bemelab/nrf24L01-modules/README.md

# nRF24L01+ modülleri — Elfatek

nRF24L01+ tabanlı RF modül tasarımları. Her proje kendi klasöründe, kendi README'si ve tasarım notlarıyla durur.

| Proje | Klasör | İçerik |
|---|---|---|
| **nRF24L01+ PA/LNA modülleri** | [`nrf24-pa-module/`](nrf24-pa-module) | 19 mm genişlikte, standart 2×4 pin dizilimli kartlar: NRF24PA, NRF24PL (RFX2401C PA/LNA), NRF24DN (PA'sız), NRF24DP (PA'lı, regülatörlü) |

Tasarımlar KiCad 9 ile, tablolardan Python betikleriyle üretilir. **Kartlar henüz test edilmedi.**
