bemelab/nrf24L01-modules/nrf24-pa-module/NRF24DP/docs/kart_alt.png

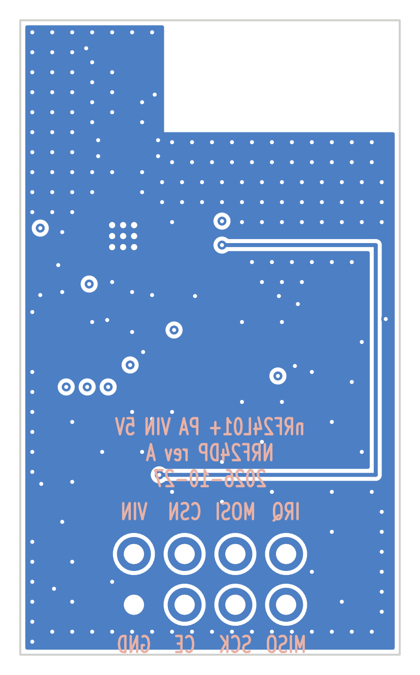
nrf24-pa-module/NRF24DP/docs/kart_alt.png
