bemelab/nrf24L01-modules/nrf24-pa-module/uretim/NRF24PA_BOM.csv

Referans | Deger | Footprint | MPN | Adet | DNP
AE1 | 2450AT18A100E | RF_Antenna:Johanson_2450AT18x100 | Johanson 2450AT18A100E | 1
C1,C2 | 22pF | Capacitor_SMD:C_0402_1005Metric | NP0 50V | 2
C3 | 2.2nF | Capacitor_SMD:C_0402_1005Metric | X7R | 1
C4 | 4.7pF | Capacitor_SMD:C_0402_1005Metric | NP0 +/-0.25pF | 1
C5,C16,C17,C18,C19 | 1.5pF | Capacitor_SMD:C_0402_1005Metric | NP0 +/-0.1pF | 5
C6 | 1.0pF | Capacitor_SMD:C_0402_1005Metric | NP0 +/-0.1pF | 1
C7 | 33nF | Capacitor_SMD:C_0402_1005Metric | X7R | 1
C8 | 1nF | Capacitor_SMD:C_0402_1005Metric | X7R | 1
C9 | 10nF | Capacitor_SMD:C_0402_1005Metric | X7R | 1
C10 | 10uF | Capacitor_SMD:C_0805_2012Metric | X5R 10V | 1
C11 | 100nF | Capacitor_SMD:C_0402_1005Metric | X7R | 1
C12 | 1uF | Capacitor_SMD:C_0402_1005Metric | X5R 10V | 1
C13 | 220pF | Capacitor_SMD:C_0402_1005Metric | NP0 | 1
C14 | 10uF | Capacitor_SMD:C_0603_1608Metric | X5R 10V | 1
C15 | 0.3pF | Capacitor_SMD:C_0402_1005Metric | NP0 +/-0.05pF | 1
C20,C21 | DNP | Capacitor_SMD:C_0402_1005Metric |  | 2 | Yerleştirilmemeli
J1 | nRF24 2x4 | Connector_PinHeader_2.54mm:PinHeader_2x04_P2.54mm_Vertical |  | 1
J2 | U.FL | Connector_Coaxial:U.FL_Hirose_U.FL-R-SMT-1_Vertical | Hirose U.FL-R-SMT-1(10) | 1
L1 | 8.2nH | Inductor_SMD:L_0402_1005Metric | LQG15HS8N2J02 (Murata) | 1
L2 | 2.7nH | Inductor_SMD:L_0402_1005Metric | LQG15HS2N7S02 | 1
L3 | 3.9nH | Inductor_SMD:L_0402_1005Metric | LQG15HS3N9S02 | 1
L4,L5 | 2.4nH | Inductor_SMD:L_0402_1005Metric | LQG15HS2N4S02 | 2
L6 | 0R | Inductor_SMD:L_0402_1005Metric |  | 1
R1 | 22k 1% | Resistor_SMD:R_0402_1005Metric |  | 1
R2,R3 | 10k | Resistor_SMD:R_0402_1005Metric |  | 2
R4 | 10k | Resistor_SMD:R_0402_1005Metric |  | 1 | Yerleştirilmemeli
R5 | 0R | Resistor_SMD:R_0402_1005Metric |  | 1 | Yerleştirilmemeli
R6 | 0R | Resistor_SMD:R_0402_1005Metric |  | 1
U1 | nRF24L01P | Package_DFN_QFN:QFN-20-1EP_4x4mm_P0.5mm_EP2.5x2.5mm | nRF24L01P-R | 1
U2 | RFX2401C | Package_DFN_QFN:QFN-16-1EP_3x3mm_P0.5mm_EP1.7x1.7mm_ThermalVias | RFX2401C (Skyworks) / AT2401C | 1
X1 | 16MHz CL=12pF | Crystal:Crystal_SMD_3225-4Pin_3.2x2.5mm | X322516MLB4SI (Yangxing) / esdegeri, +/-20ppm | 1
