bemelab/nrf24L01-modules/nrf24-pa-module/NRF24DN/uretim/NRF24DN_BOM.csv

Referans | Deger | Footprint | MPN | Adet | DNP
AE1 | 2450AT18A100E | RF_Antenna:Johanson_2450AT18x100 | Johanson 2450AT18A100E | 1
B1 | 2450BM14A0002 | elf_rf:Johanson_2450BM14_1.6x0.8mm | Johanson 2450BM14A0002001T | 1
C1,C2 | 22pF | Capacitor_SMD:C_0402_1005Metric | NP0 50V | 2
C3 | 2.2nF | Capacitor_SMD:C_0402_1005Metric | X7R | 1
C4,C5 | DNP | Capacitor_SMD:C_0402_1005Metric |  | 2 | Yerleştirilmemeli
C6 | 10uF | Capacitor_SMD:C_0805_2012Metric | X5R 25V | 1
C7 | 33nF | Capacitor_SMD:C_0402_1005Metric | X7R | 1
C8 | 1nF | Capacitor_SMD:C_0402_1005Metric | X7R | 1
C9 | 10nF | Capacitor_SMD:C_0402_1005Metric | X7R | 1
C10 | 22uF | Capacitor_Tantalum_SMD:CP_EIA-3216-18_Kemet-A | Tantal 22uF 10V A kilif | 1
J1 | nRF24 2x4 | Connector_PinHeader_2.54mm:PinHeader_2x04_P2.54mm_Vertical |  | 1
L1 | 0R | Inductor_SMD:L_0402_1005Metric |  | 1
R1 | 22k 1% | Resistor_SMD:R_0402_1005Metric |  | 1
U1 | nRF24L01P | Package_DFN_QFN:QFN-20-1EP_4x4mm_P0.5mm_EP2.5x2.5mm | nRF24L01P-R | 1
U2 | AMS1117-3.3 | Package_TO_SOT_SMD:SOT-223-3_TabPin2 | AMS1117-3.3 (AMS) / esdegeri | 1
X1 | 16MHz CL=12pF | Crystal:Crystal_SMD_3225-4Pin_3.2x2.5mm | X322516MLB4SI (Yangxing) / esdegeri, +/-20ppm | 1
