bemelab/nrf24L01-modules/nrf24-pa-module/NRF24DN/uretim/NRF24DN.step

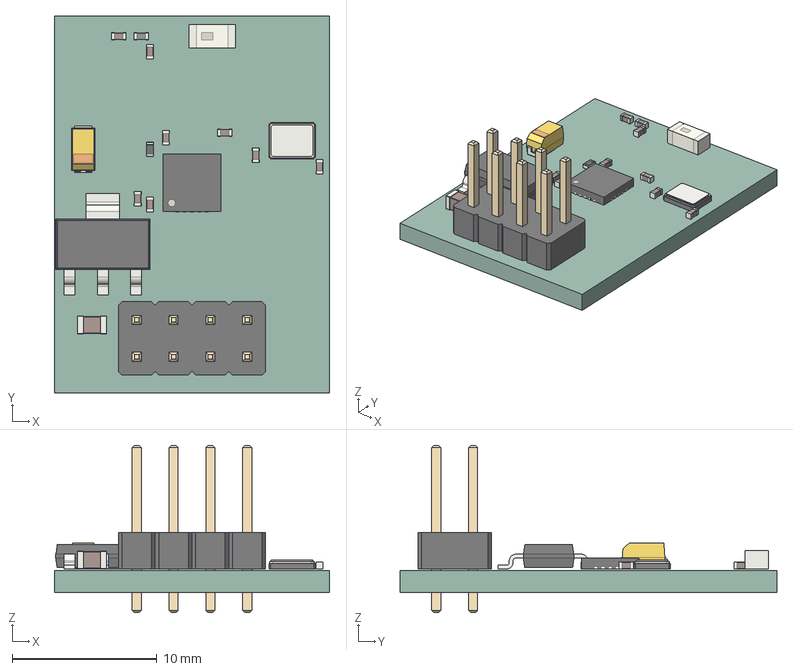
[picture p7: CAD file, 2026-10-27]
nrf24-pa-module/NRF24DN/uretim/NRF24DN.step
19.0 x 26.0 x 11.5 mm
C_0402_1005Metric x 8
CP_EIA-3216-18_Kemet-A
Crystal_SMD_3225-4Pin_3.2x2.5mm
PinHeader_2x04_P2.54mm_Vertical
R_0402_1005Metric
QFN-20-1EP_4x4mm_P0.5mm_EP2.5x2.5mm
L_0402_1005Metric
Johanson_2450AT18x100
C_0805_2012Metric
SOT-223
NRF24DN_PCB
