bemelab/nrf24L01-modules/nrf24-pa-module/NRF24DP/uretim/NRF24DP.step

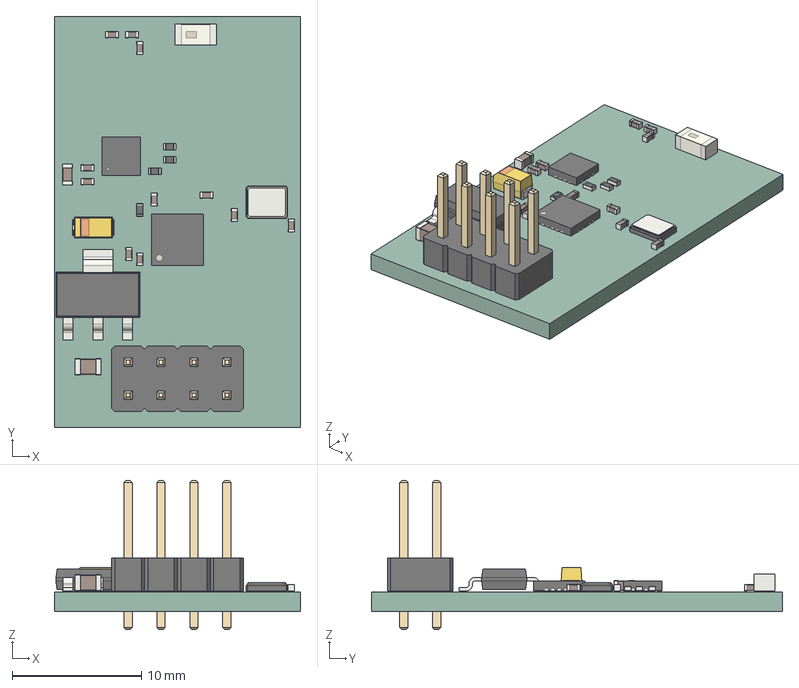
[picture p8: CAD file, 2026-10-27]
nrf24-pa-module/NRF24DP/uretim/NRF24DP.step
19.0 x 31.8 x 11.5 mm
C_0402_1005Metric x 10
QFN-20-1EP_4x4mm_P0.5mm_EP2.5x2.5mm
Crystal_SMD_3225-4Pin_3.2x2.5mm
C_0805_2012Metric
R_0402_1005Metric x 4
Johanson_2450AT18x100
SOT-223
CP_EIA-3216-18_Kemet-A
PinHeader_2x04_P2.54mm_Vertical
QFN-16-1EP_3x3mm_P0.5mm_EP1.7x1.7mm
L_0402_1005Metric
C_0603_1608Metric
NRF24DP_PCB
