bemelab/nrf24L01-modules/nrf24-pa-module/NRF24PL/uretim/NRF24PL.step

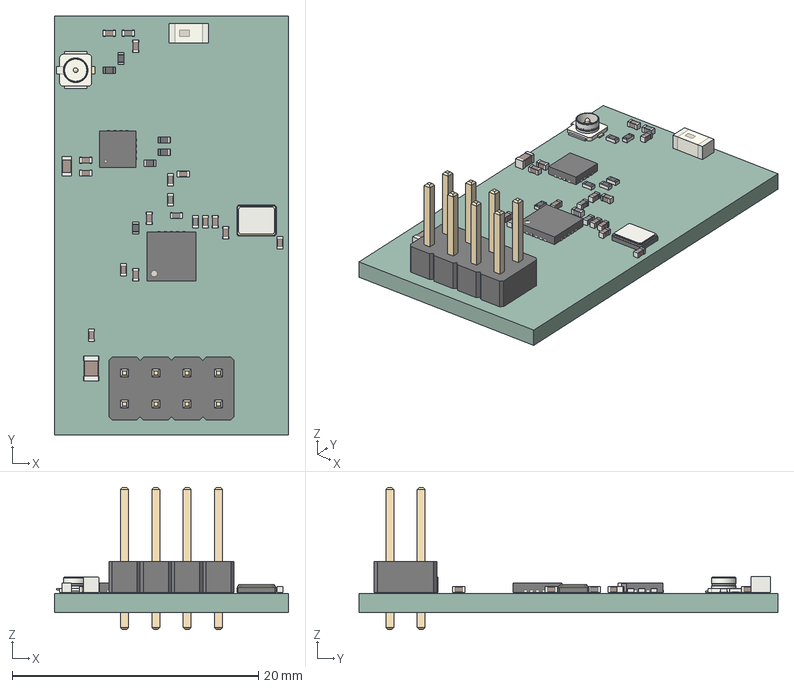
[picture p9: CAD file, 2026-10-27]
nrf24-pa-module/NRF24PL/uretim/NRF24PL.step
19.0 x 34.0 x 11.5 mm
C_0402_1005Metric x 14
R_0402_1005Metric x 6
QFN-20-1EP_4x4mm_P0.5mm_EP2.5x2.5mm
PinHeader_2x04_P2.54mm_Vertical
L_0402_1005Metric x 4
QFN-16-1EP_3x3mm_P0.5mm_EP1.7x1.7mm
C_0805_2012Metric
U.FL_Hirose_U.FL-R-SMT-1_Vertical
C_0603_1608Metric
Crystal_SMD_3225-4Pin_3.2x2.5mm
Johanson_2450AT18x100
NRF24PL_PCB
