bemelab/nrf24L01-modules/(list of files, cad)

Other CAD files:
nrf24-pa-module/uretim/NRF24PA.step
