bemelab/nrf24L01-modules/nrf24-pa-module/uretim/NRF24PA_sema.pdf

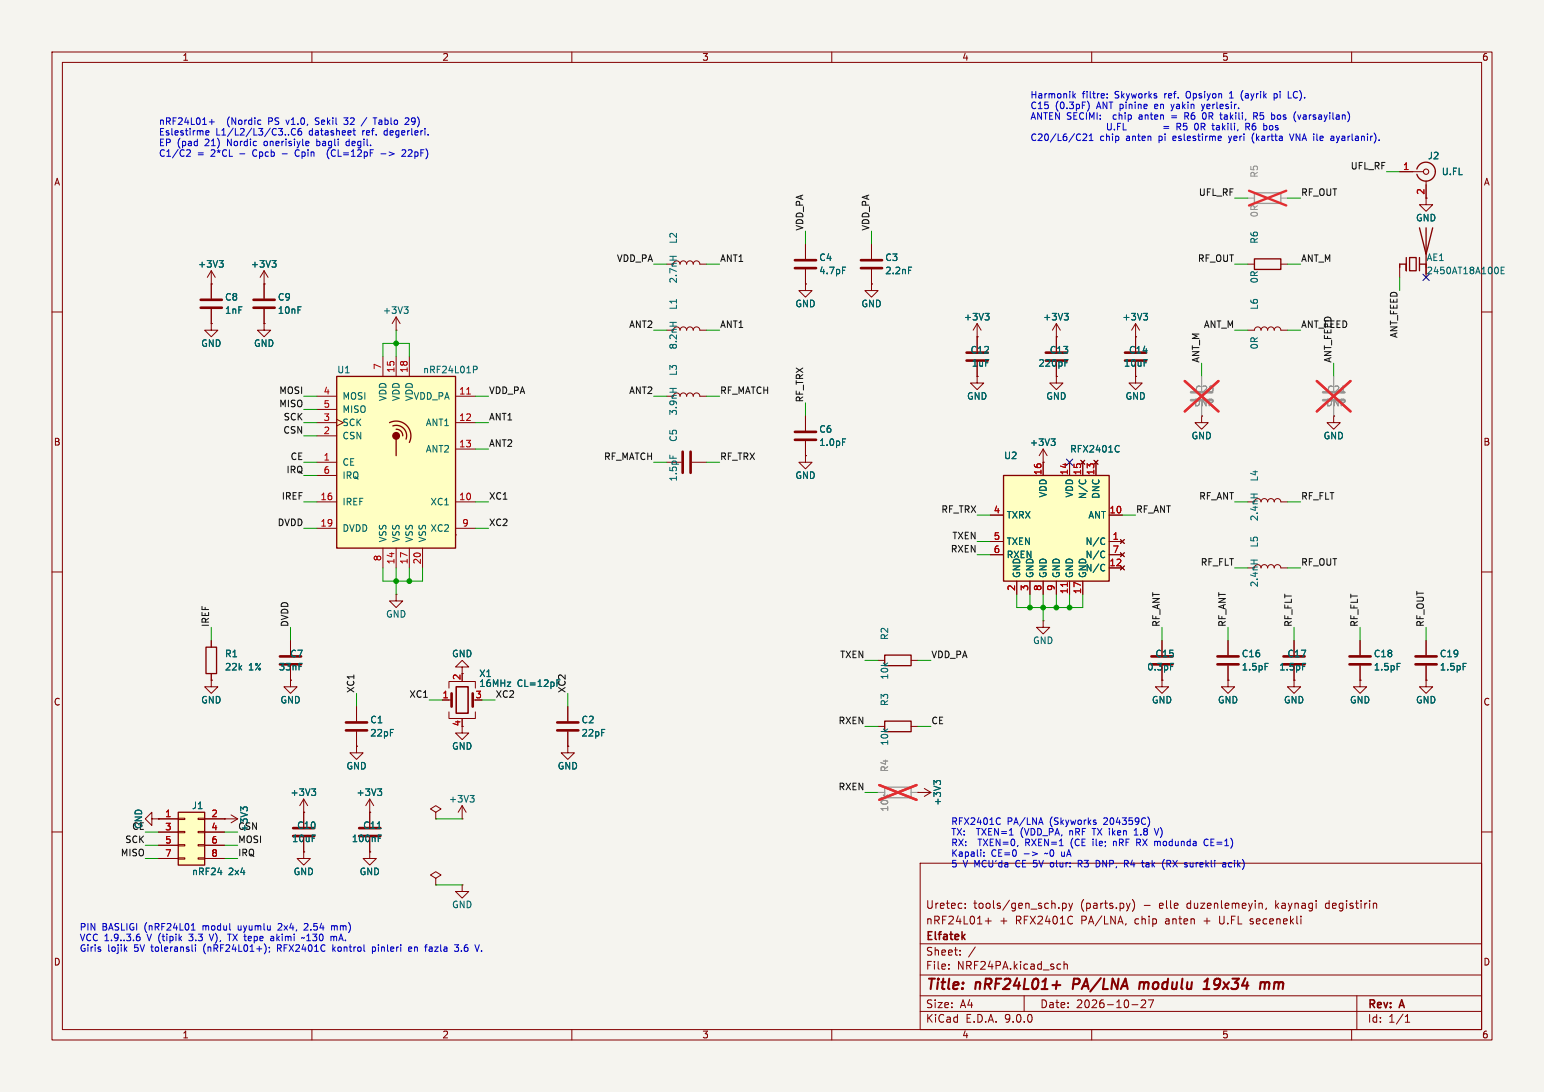
[picture p10: page 1]

8 VDD 15 VSS 14 VDD 18 VSS 17 VSS 20 VDD_PA 11 ANT1 12 ANT2 13 XC1 10 XC2 9 U1 nRF24L01P R2 10k +3V3 TXRX 4 TXEN 5 RXEN 6 GND

9 VDD 14 GND 11 N/C 15 GND 17 DNC 13 ANT 10 N/C 1 N/C 7 N/C 12 +3V3 R4 10k+3V3 GND

9 VDD 14 GND 11 N/C 15 GND 17 DNC 13 ANT 10 N/C 1 N/C 7 N/C 12 U2 RFX2401C

5 V MCU'da CE 5V olur: R3 DNP, R4 tak (RX surekli acik)
