bemelab/nrf24L01-modules/nrf24-pa-module/NRF24DP/uretim/NRF24DP_sema.pdf

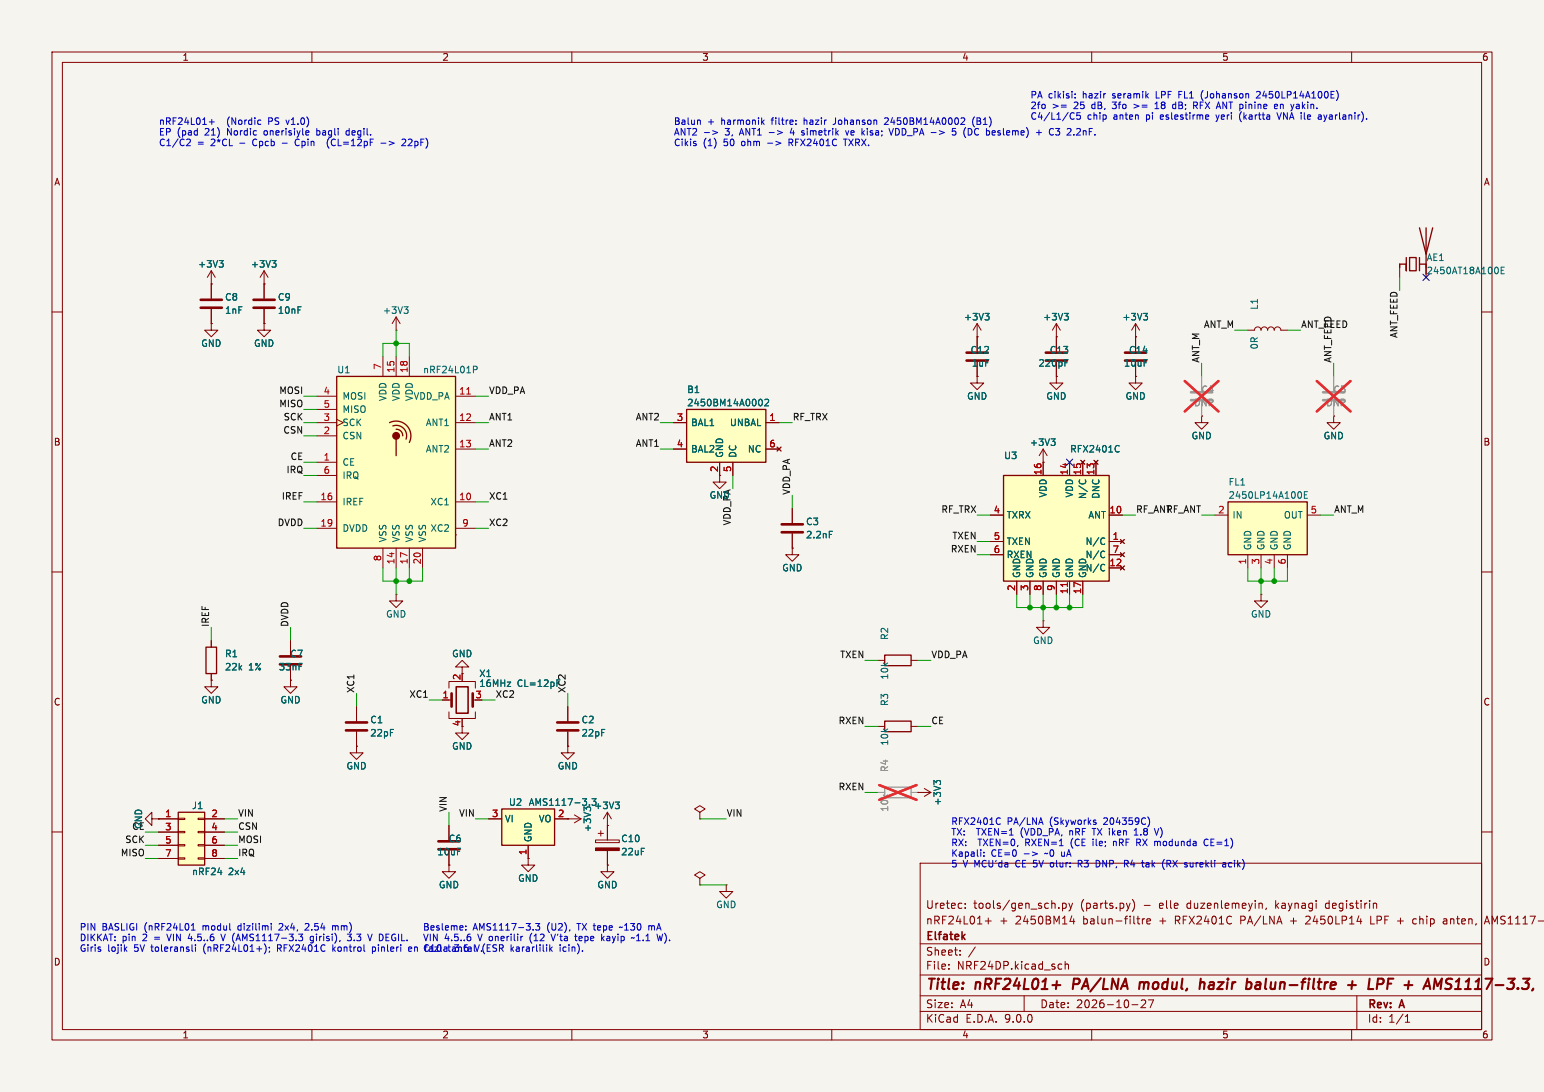
[picture p11: page 1]

9 VDD 14 GND 11 N/C 15 GND 17 DNC 13 ANT 10 N/C 1 N/C 7 N/C 12 GND R4 10k+3V3 C14

8 VDD 15 VSS 14 VDD 18 VSS 17 VSS 20 VDD_PA 11 ANT1 12 ANT2 13 XC1 10 XC2 9 U1 nRF24L01P GND GND GND GND

9 VDD 14 GND 11 N/C 15 GND 17 DNC 13 ANT 10 N/C 1 N/C 7 N/C 12 U3 RFX2401C GND
