bemelab/nrf24L01-modules/nrf24-pa-module/uretim/NRF24PA_montaj_ust.pdf

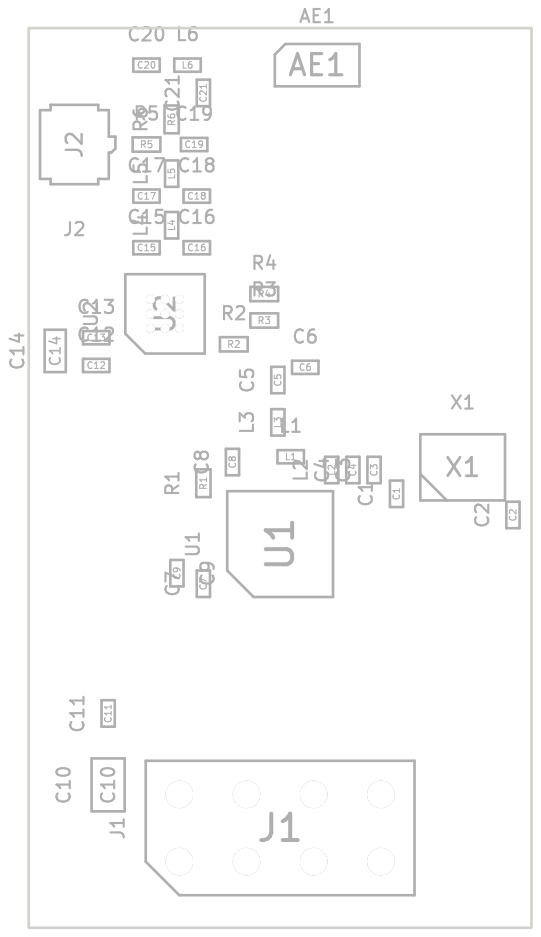
[picture p13: page 1]
