bemelab/nrf24L01-modules/nrf24-pa-module/NRF24DN/uretim/NRF24DN_montaj_ust.pdf

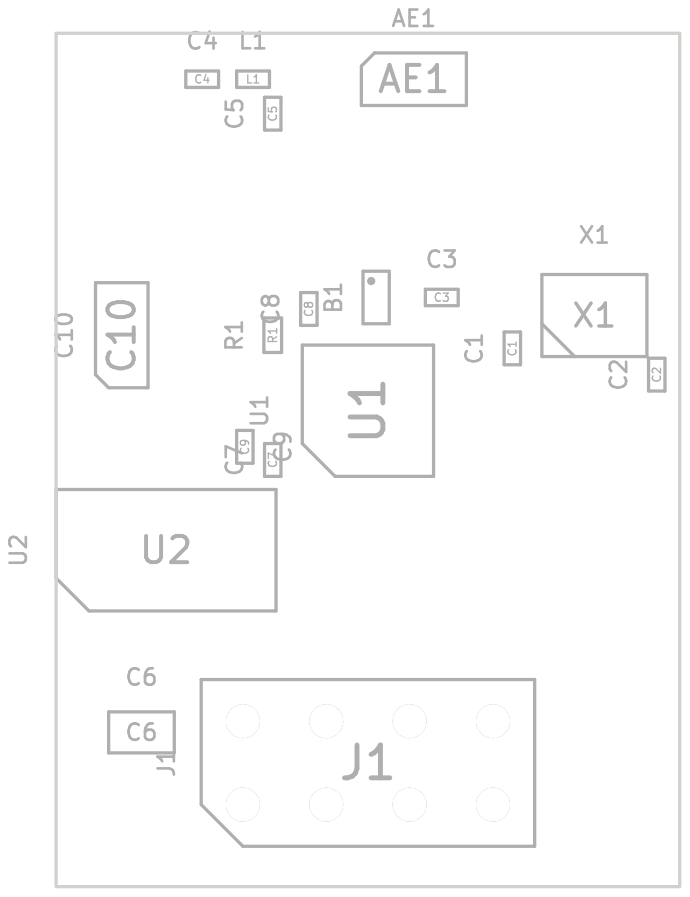
[picture p14: page 1]
