bemelab/nrf24L01-modules/nrf24-pa-module/NRF24DP/uretim/NRF24DP_montaj_ust.pdf

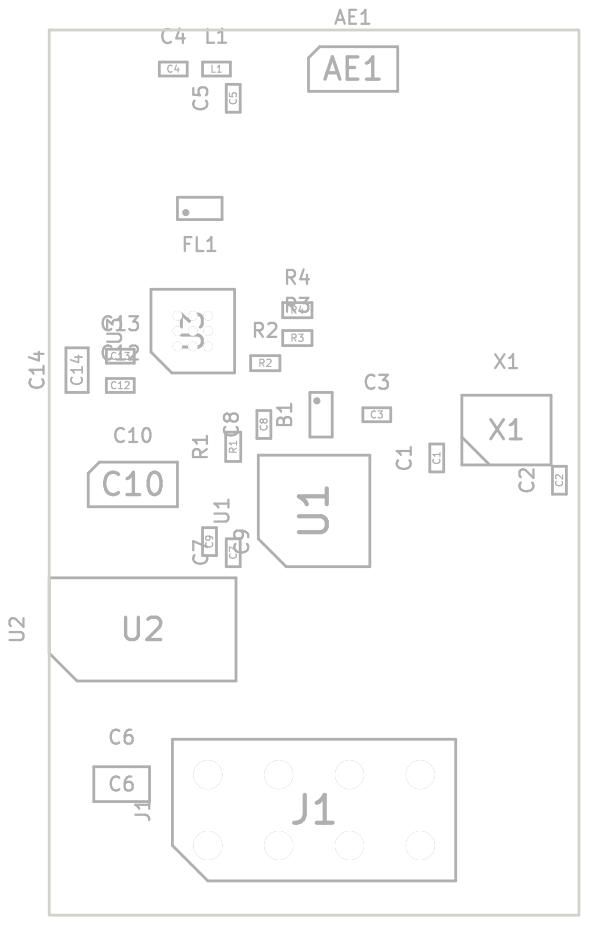
[picture p15: page 1]
