bemelab/nrf24L01-modules/nrf24-pa-module/NRF24PL/uretim/NRF24PL_montaj_ust.pdf

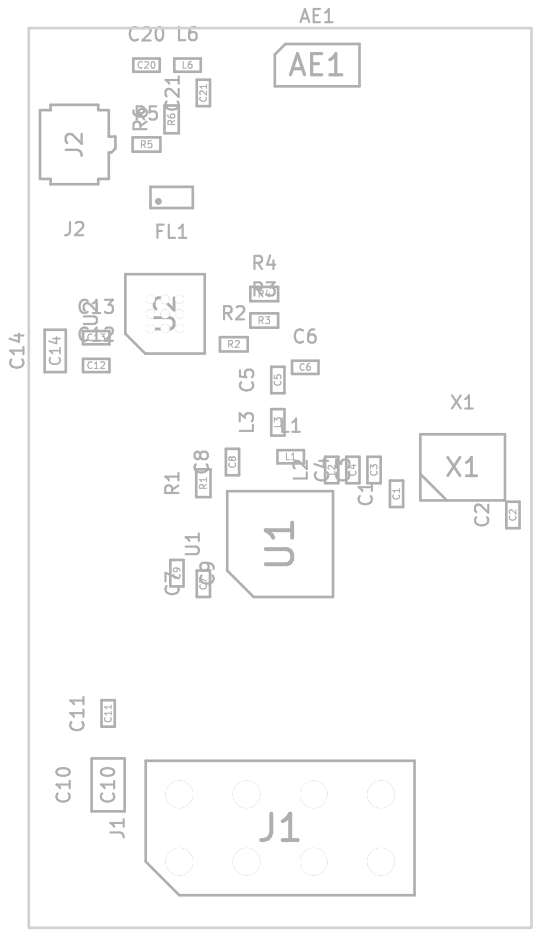
[picture p16: page 1]
