bemelab/nrf24L01-modules/nrf24-pa-module/NRF24DN/kicad/NRF24DN.kicad_pcb

## KiCad design nrf24-pa-module/NRF24DN/kicad/NRF24DN.kicad_pcb (2026-10-27)

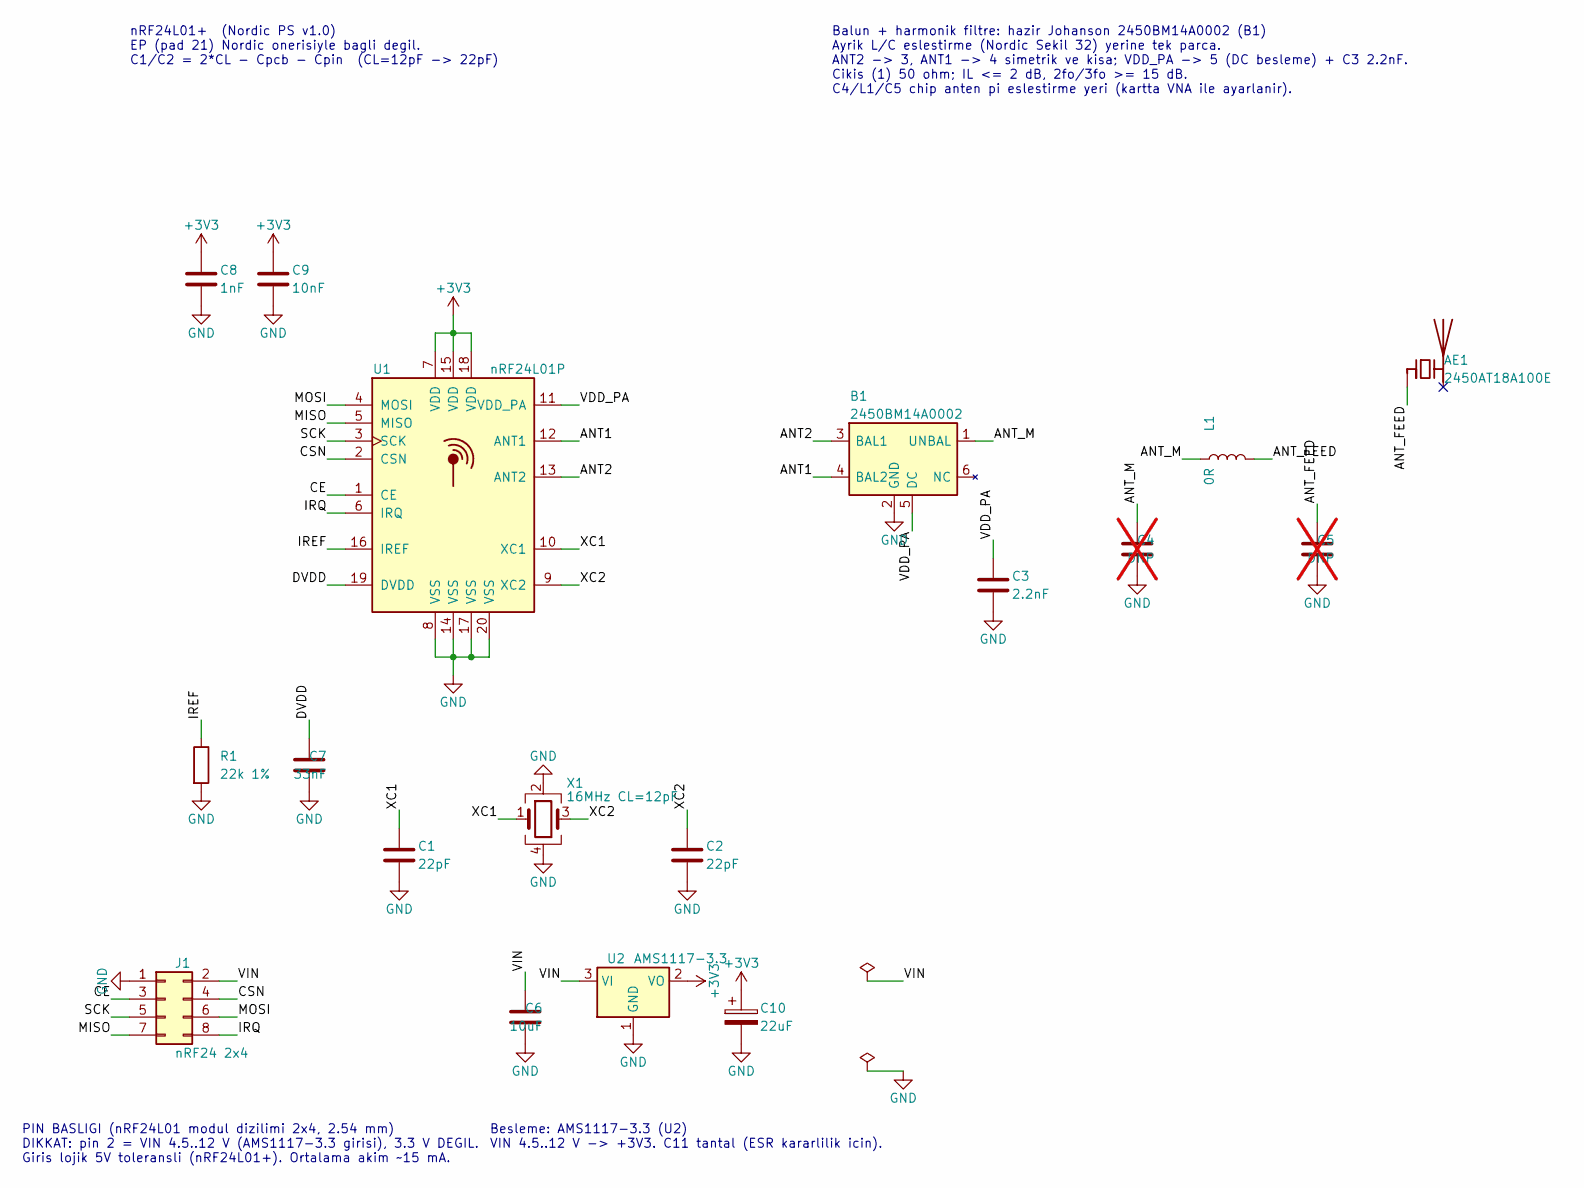
[picture p17: schematic NRF24DN.kicad_sch, nRF24L01+ minimal modul, hazir balun-filtre + AMS1117-3.3, …]

Parts:
AE1: 2450AT18A100E; Johanson_2450AT18x100; MPN Johanson 2450AT18A100E
B1: 2450BM14A0002; Johanson_2450BM14_1.6x0.8mm; MPN Johanson 2450BM14A0002001T
C1, C2: 22pF; C_0402_1005Metric; MPN NP0 50V
C3: 2.2nF; C_0402_1005Metric; MPN X7R
C4, C5: DNP; C_0402_1005Metric; not fitted
C6: 10uF; C_0805_2012Metric; MPN X5R 25V
C7: 33nF; C_0402_1005Metric; MPN X7R
C8: 1nF; C_0402_1005Metric; MPN X7R
C9: 10nF; C_0402_1005Metric; MPN X7R
C10: 22uF; CP_EIA-3216-18_Kemet-A; MPN Tantal 22uF 10V A kilif
J1: nRF24 2x4; PinHeader_2x04_P2.54mm_Vertical
L1: 0R; L_0402_1005Metric
R1: 22k 1%; R_0402_1005Metric
U1: nRF24L01P; QFN-20-1EP_4x4mm_P0.5mm_EP2.5x2.5mm; MPN nRF24L01P-R
U2: AMS1117-3.3; SOT-223-3_TabPin2; MPN AMS1117-3.3 (AMS) / esdegeri
X1: 16MHz CL=12pF; Crystal_SMD_3225-4Pin_3.2x2.5mm; MPN X322516MLB4SI (Yangxing) / esdegeri, +/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

Connections:
+3V3: C8.1, C9.1, C10.1, U1.7 (VDD), U1.15 (VDD), U1.18 (VDD), U2.2 (VO)
/ANT1: B1.4 (BAL2), U1.12 (ANT1)
/ANT2: B1.3 (BAL1), U1.13 (ANT2)
/ANT_FEED: AE1.1 (FEED), C5.2, L1.2
/ANT_M: B1.1 (UNBAL), C4.2, L1.1
/CE: J1.3, U1.1 (CE)
/CSN: J1.4, U1.2 (CSN)
/DVDD: C7.2, U1.19 (DVDD)
/IREF: R1.1, U1.16 (IREF)
/IRQ: J1.8, U1.6 (IRQ)
/MISO: J1.7, U1.5 (MISO)
/MOSI: J1.6, U1.4 (MOSI)
/SCK: J1.5, U1.3 (SCK)
/VDD_PA: B1.5 (DC), C3.1, U1.11 (VDD_PA)
/VIN: C6.2, J1.2, U2.3 (VI)
/XC1: C1.1, U1.10 (XC1), X1.1
/XC2: C2.1, U1.9 (XC2), X1.3
GND: B1.2 (GND), C1.2, C2.2, C3.2, C4.1, C5.1, C6.1, C7.1, C8.2, C9.2, C10.2, J1.1, R1.2, U1.8 (VSS), U1.14 (VSS), U1.17 (VSS), U1.20 (VSS), U2.1 (GND), X1.2, X1.4

Notes on the sheet:
PIN BASLIGI (nRF24L01 modul dizilimi 2x4, 2.54 mm) DIKKAT: pin 2 = VIN 4.5..12 V (AMS1117-3.3 girisi), 3.3 V DEGIL. Giris lojik 5V toleransli (nRF24L01+). Ortalama akim ~15 mA.
nRF24L01+ (Nordic PS v1.0) EP (pad 21) Nordic onerisiyle bagli degil. C1/C2 = 2*CL - Cpcb - Cpin (CL=12pF -> 22pF)
Balun + harmonik filtre: hazir Johanson 2450BM14A0002 (B1) Ayrik L/C eslestirme (Nordic Sekil 32) yerine tek parca. ANT2 -> 3, ANT1 -> 4 simetrik ve kisa; VDD_PA -> 5 (DC besleme) + C3 2.2nF. Cikis (1) 50 ohm; IL <= 2 dB, 2fo/3fo >= 15 dB. C4/L1/C5 chip anten pi eslestirme yeri (kartta VNA ile ayar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
Besleme: AMS1117-3.3 (U2) VIN 4.5..12 V -> +3V3. C11 tantal (ESR kararlilik icin).

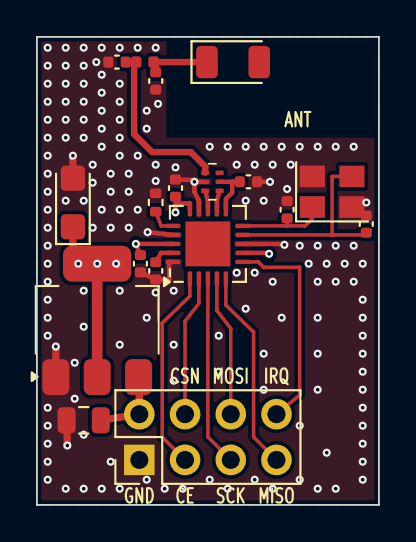
[picture p18: board NRF24DN.kicad_pcb from above]

Board: 4 copper layers, 19.0 x 26.0 mm, 18 parts (0 on the bottom side), 18 nets.
