bemelab/nrf24L01-modules/(commit log)

2026-10-27 NRF24PA ve NRF24PL nRF24L01+ PA/LNA modülleri, rev A
    - NRF24PA: nRF24L01+ + RFX2401C, ayrık pi LC harmonik filtre
    - NRF24PL: aynı kart, filtre yerine Johanson 2450LP14A100E seramik LPF (FL1)
    - KiCad 9 projeleri, üreteç betikleri (tools/), Gerber/BOM/dizgi/PDF/STEP
    - ERC 0, DRC 0 hata / 0 bağlantısız; kartta henüz test edilmedi
    [NRF24PA-B_Cu.gbr, NRF24PA-B_Mask.gbr, NRF24PA-B_Paste.gbr, NRF24PA-B_Silkscreen.gbr, NRF24PA-Edge_Cuts.gbr, NRF24PA-F_Cu.gbr, NRF24PA-F_Mask.gbr, NRF24PA-F_Paste.gbr]
2026-10-27 NRF24DN ve NRF24DP modülleri, rev A
    NRF24DN: PA'sız minimal modül, hazır balun-filtre + AMS1117-3.3, 19 x 26 mm.
    NRF24DP: PA/LNA, hazır balun-filtre + LPF + AMS1117-3.3, 19 x 31.75 mm.
    README kart tablosu güncellendi. Kartlar henüz test edilmedi.
    [NRF24DN-B_Cu.gbr, NRF24DN-B_Mask.gbr, NRF24DN-B_Paste.gbr, NRF24DN-B_Silkscreen.gbr, NRF24DN-Edge_Cuts.gbr, NRF24DN-F_Cu.gbr, NRF24DN-F_Mask.gbr, NRF24DN-F_Paste.gbr]
2026-10-27 Depo birden çok proje için düzenlendi: nrf24-pa-module/ alt klasörü
    NRF24PA, NRF24PL, NRF24DN ve NRF24DP tasarımları içerik değişmeden
    nrf24-pa-module/ altına taşındı. Kök README proje listesi oldu.
    Yeni yerden NRF24PA yeniden üretildi: ERC 0, DRC 6 serigrafi uyarısı, bağlantısız 0.
    [NRF24DN-B_Cu.gbr, NRF24DN-B_Mask.gbr, NRF24DN-B_Paste.gbr, NRF24DN-B_Silkscreen.gbr, NRF24DN-Edge_Cuts.gbr, NRF24DN-F_Cu.gbr, NRF24DN-F_Mask.gbr, NRF24DN-F_Paste.gbr]
